atang618/avocado-pcb/README.md

View this project on [CADLAB.io](https://cadlab.io/node/873). 

# avocado-pcb
PCB files for a smart actuator enabling chaining and providing precise positional control
