atang618/avocado-pcb/avocado/optical_encoder.brd

## EAGLE design avocado/optical_encoder.brd (2018-05-08)

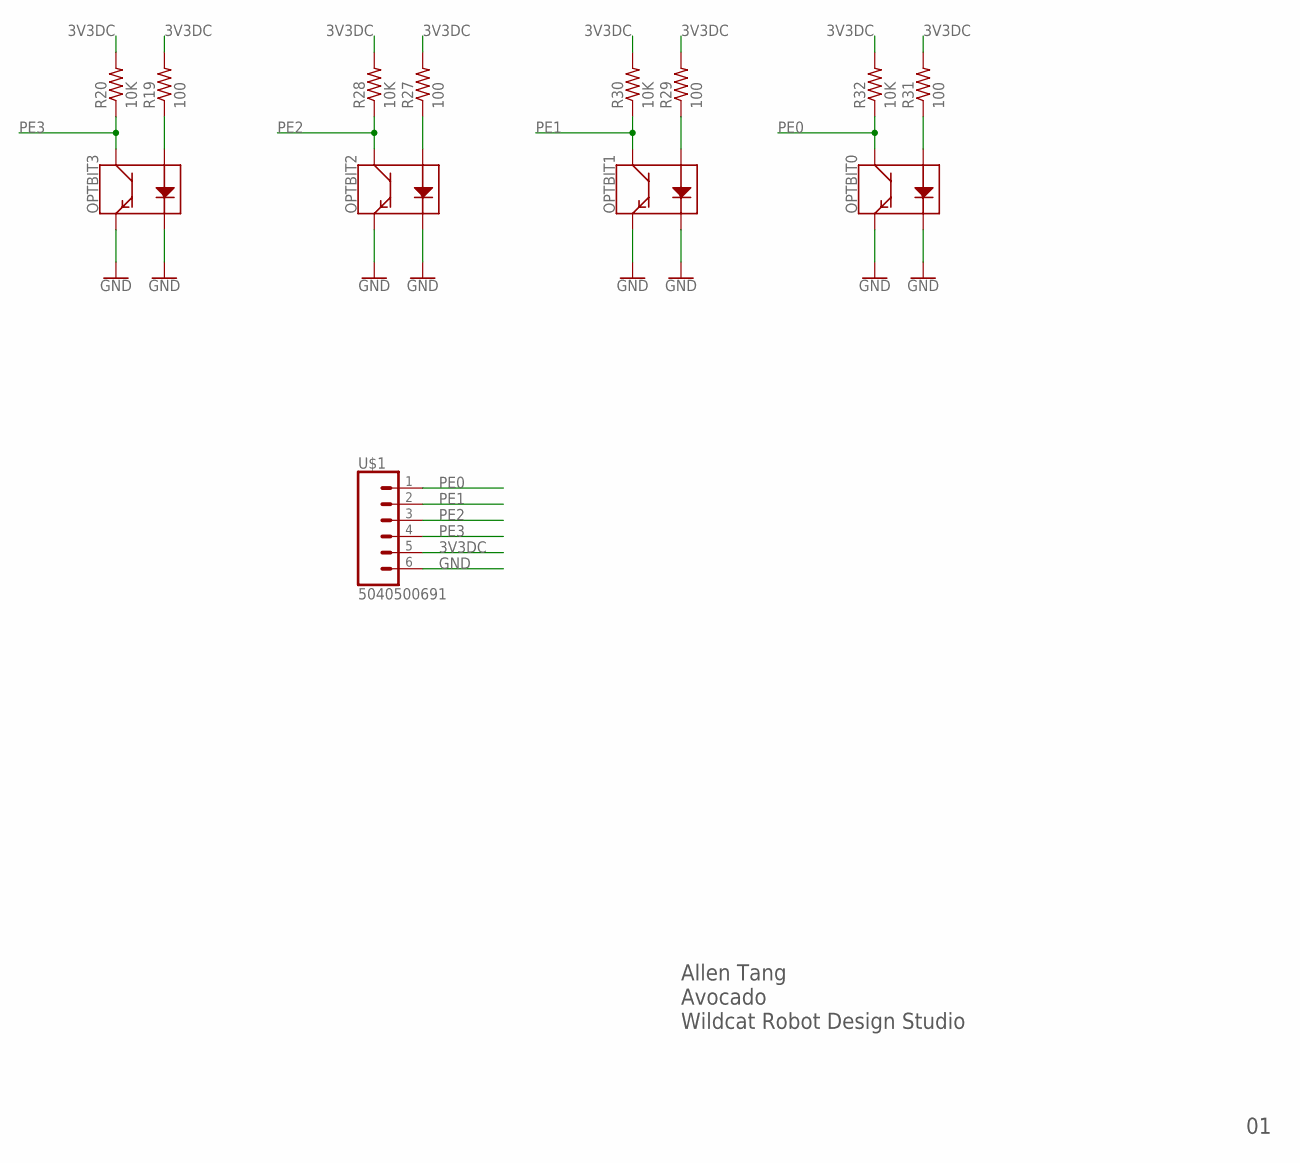
[picture p4: schematic optical_encoder.sch]

Parts:
OPTBIT0, OPTBIT1, OPTBIT2, OPTBIT3: QRE1113
R19, R27, R29, R31: 100; R0402
R20, R28, R30, R32: 10K; R0402
U$1: 5040500691

Connections:
3V3DC: R19.2, R20.2, R27.2, R28.2, R29.2, R30.2, R31.2, R32.2, U$1.5
GND: OPTBIT0.2 (K), OPTBIT0.4 (E), OPTBIT1.2 (K), OPTBIT1.4 (E), OPTBIT2.2 (K), OPTBIT2.4 (E), OPTBIT3.2 (K), OPTBIT3.4 (E), U$1.6
unnamed: OPTBIT3.1 (A), R19.1
unnamed: OPTBIT2.1 (A), R27.1
unnamed: OPTBIT1.1 (A), R29.1
unnamed: OPTBIT0.1 (A), R31.1
PE0: OPTBIT0.3 (C), R32.1, U$1.1
PE1: OPTBIT1.3 (C), R30.1, U$1.2
PE2: OPTBIT2.3 (C), R28.1, U$1.3
PE3: OPTBIT3.3 (C), R20.1, U$1.4

Notes on the sheet:
Allen Tang Avocado Wildcat Robot Design Studio

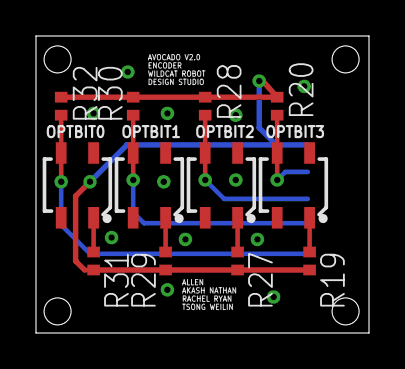
[picture p5: board optical_encoder.brd from above]

Board: 2 copper layers, 18.5 x 16.5 mm, 13 parts (1 on the bottom side), 10 nets.
