atang618/avocado-pcb/avocado/peripheral.brd

## EAGLE design avocado/peripheral.brd (2018-04-24)

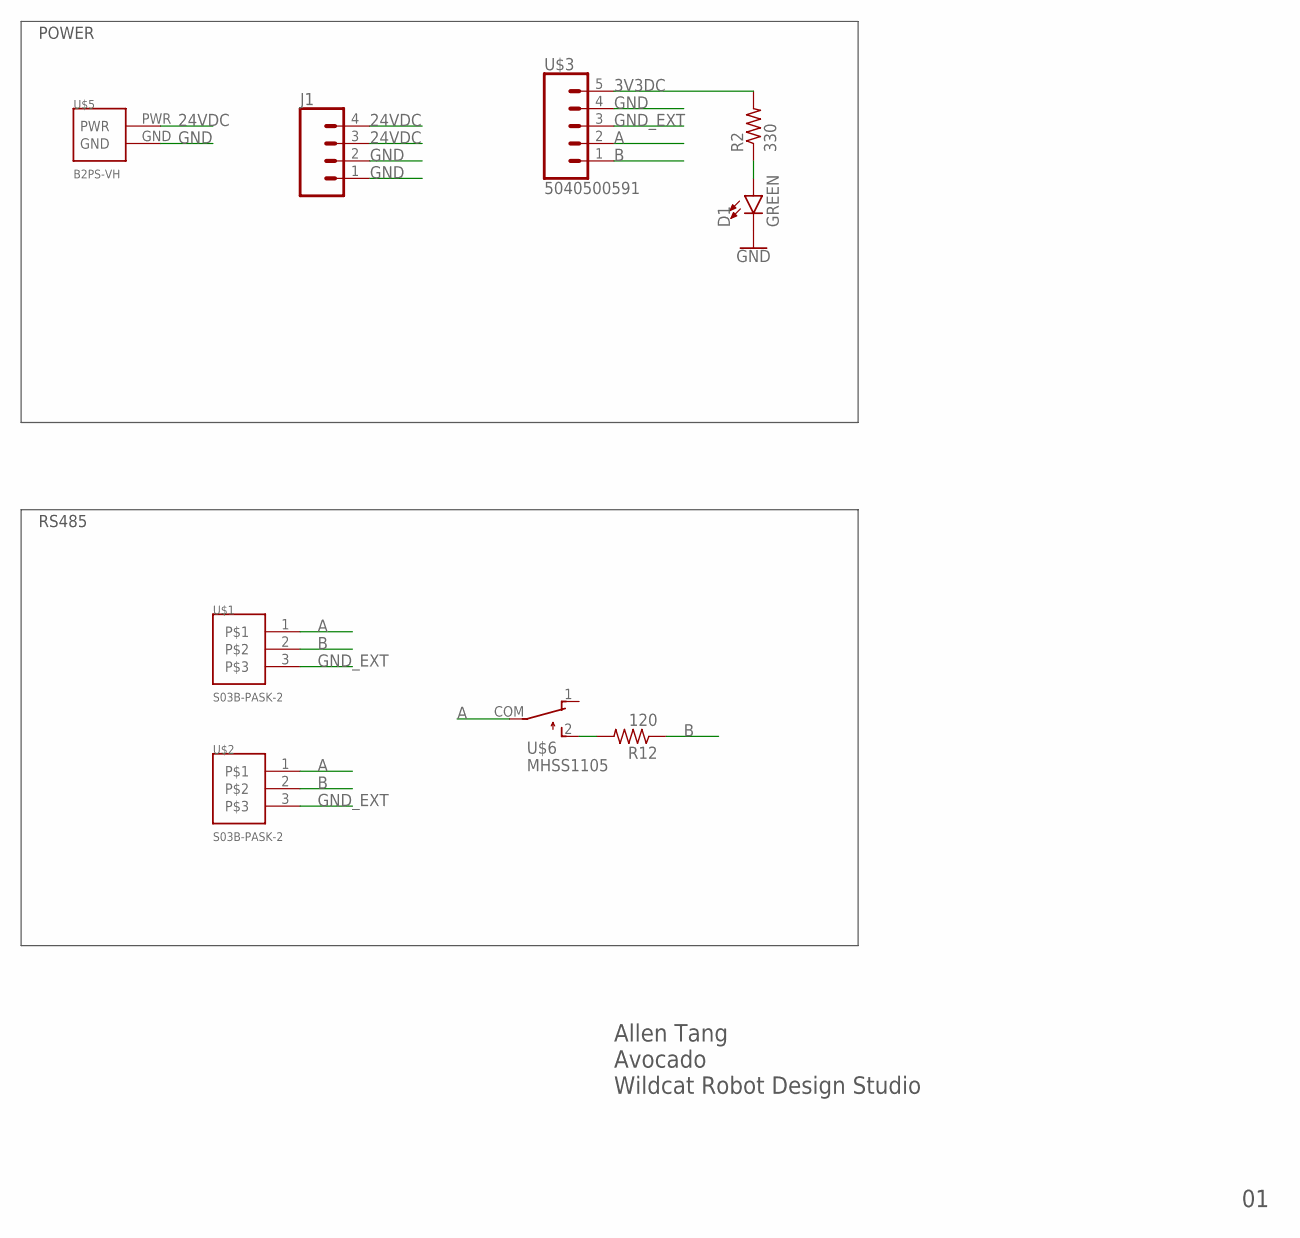
[picture p6: schematic peripheral.sch]

Parts:
D1: GREEN; LED-0603
J1: CONN_04; 1X04
R2: 330; R0805
R12: 120; R0805
U$1, U$2: S03B-PASK-2
U$3: 5040500591
U$5: B2PS-VH
U$6: MHSS1105

Connections:
3V3DC: R2.2, U$3.5
24VDC: J1.3, J1.4, U$5.PWR
A: U$1.1, U$2.1, U$3.2, U$6.COM
B: R12.1, U$1.2, U$2.2, U$3.1
GND: D1.C, J1.1, J1.2, U$3.4, U$5.GND
GND_EXT: U$1.3, U$2.3, U$3.3
unnamed: D1.A, R2.1
unnamed: R12.2, U$6.2

Notes on the sheet:
Allen Tang Avocado Wildcat Robot Design Studio
POWER
RS485

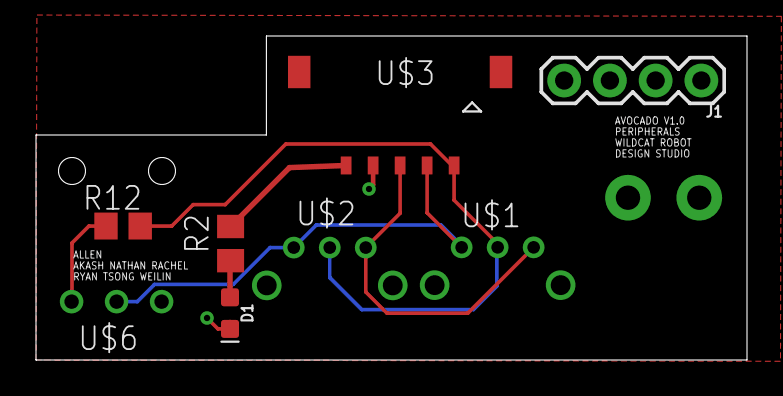
[picture p7: board peripheral.brd from above]

Board: 2 copper layers, 39.5 x 18.0 mm, 9 parts (0 on the bottom side), 8 nets.
