atang618/avocado-pcb/(commit log)

2018-02-07 initial wiring of motor driver
    [avocado_v1.0.sch]
2018-02-07 finished wiring MCU
    [avocado_v1.0.sch]
2018-02-07 fixed the title block
    [avocado_v1.0.sch]
2018-04-10 added power and encoder block
    [avocado_v1.0.sch]
2018-04-12 updated motor block, power and temperature
    [avocado_v1.0.sch]
2018-04-12 cleaned up the parts for the schematic
    [avocado_v1.0.sch]
2018-04-14 finished adding parts for motor
    [avocado_v1.0.sch]
2018-04-15 started board layout
    [avocado_v1.0.brd, avocado_v1.0.sch, encoder.brd, encoder.sch, peripheral.brd, peripheral.sch]
2018-04-15 made significant routing progress
    [avocado_v1.0.brd, avocado_v1.0.sch]
2018-04-16 started Motor traces
    [avocado_v1.0.brd]
2018-04-17 fixed all airwires, still need to fix DRC
    [avocado_v1.0.brd, encoder.brd, peripheral.brd]
2018-04-18 expanded power and motor traces
    [avocado_v1.0.brd, avocado_v1.0.sch]
2018-04-19 redesigned FET and Cap orientation
    [avocado_v1.0.brd, avocado_v1.0.sch]
2018-04-19 finished DRC and silk for version 1
    [avocado_v1.0.brd, avocado_v1.0.sch]
2018-04-19 added version and gerber files
    [avocado_v1.0.brd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]
2018-04-19 design that was ordered in first PCB run
    [avocado_v1.0.brd, avocado_v1.0.sch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]
2018-04-20 removed blind vias and generated new Gerber files
    [avocado_v1.0.GBL, avocado_v1.0.GBO, avocado_v1.0.GBP, avocado_v1.0.GBS, avocado_v1.0.GTL, avocado_v1.0.GTO, avocado_v1.0.GTP, avocado_v1.0.GTS]
2018-04-22 new gerber files and updated peripheral/main board
    [avocado_v1.0.GBL, avocado_v1.0.GBO, avocado_v1.0.GBP, avocado_v1.0.GBS, avocado_v1.0.GTL, avocado_v1.0.GTO, avocado_v1.0.GTP, avocado_v1.0.GTS]
2018-04-24 updated encoder board size
    [encoder.brd, peripheral.sch]
2018-04-24 modified peripheral board size
    [peripheral.brd]
2018-04-24 added mounting holes on peripheral board
    [peripheral.brd]
2018-04-24 updated encoder and peripheral
    [peripheral.brd]
2018-05-05 added v2.0 of the avocado main pcb
    [avocado_v1.0.brd, avocado_v1.0.sch, avocado_v2.0.brd, avocado_v2.0.sch, optical_encoder.brd, optical_encoder.sch]
2018-05-05 added mounting holes to main pcb
    [avocado_v2.0.brd]
2018-05-05 added new optical encoder board
2018-05-08 added power connector board
    [power_connector.brd, power_connector.sch]
2018-05-08 version 2 of the avocado pcb finished
    [avocado_v2.0.brd, avocado_v2.0.sch, optical_encoder.brd]
2018-05-09 finalized optical encoder and power connector boards
    [power_connector.brd, power_connector.sch]
2018-05-17 latest gerbers and main pcb design
    [avocado_v2.0.GBL, avocado_v2.0.GBO, avocado_v2.0.GBP, avocado_v2.0.GBS, avocado_v2.0.GTL, avocado_v2.0.GTO, avocado_v2.0.GTP, avocado_v2.0.GTS]
